Ser9ei/usbasp/circuit/USBisp_schematics.pdf

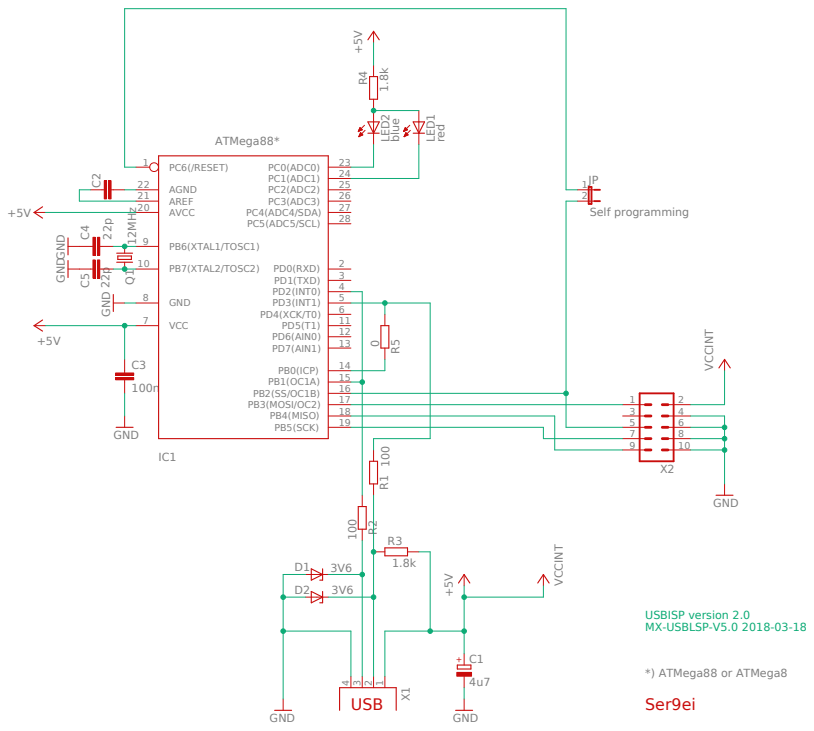
[picture p1: page 1]
