Ser9ei/usbasp/circuit/USBisp.sch

## EAGLE design circuit/USBisp.sch (2020-11-28)

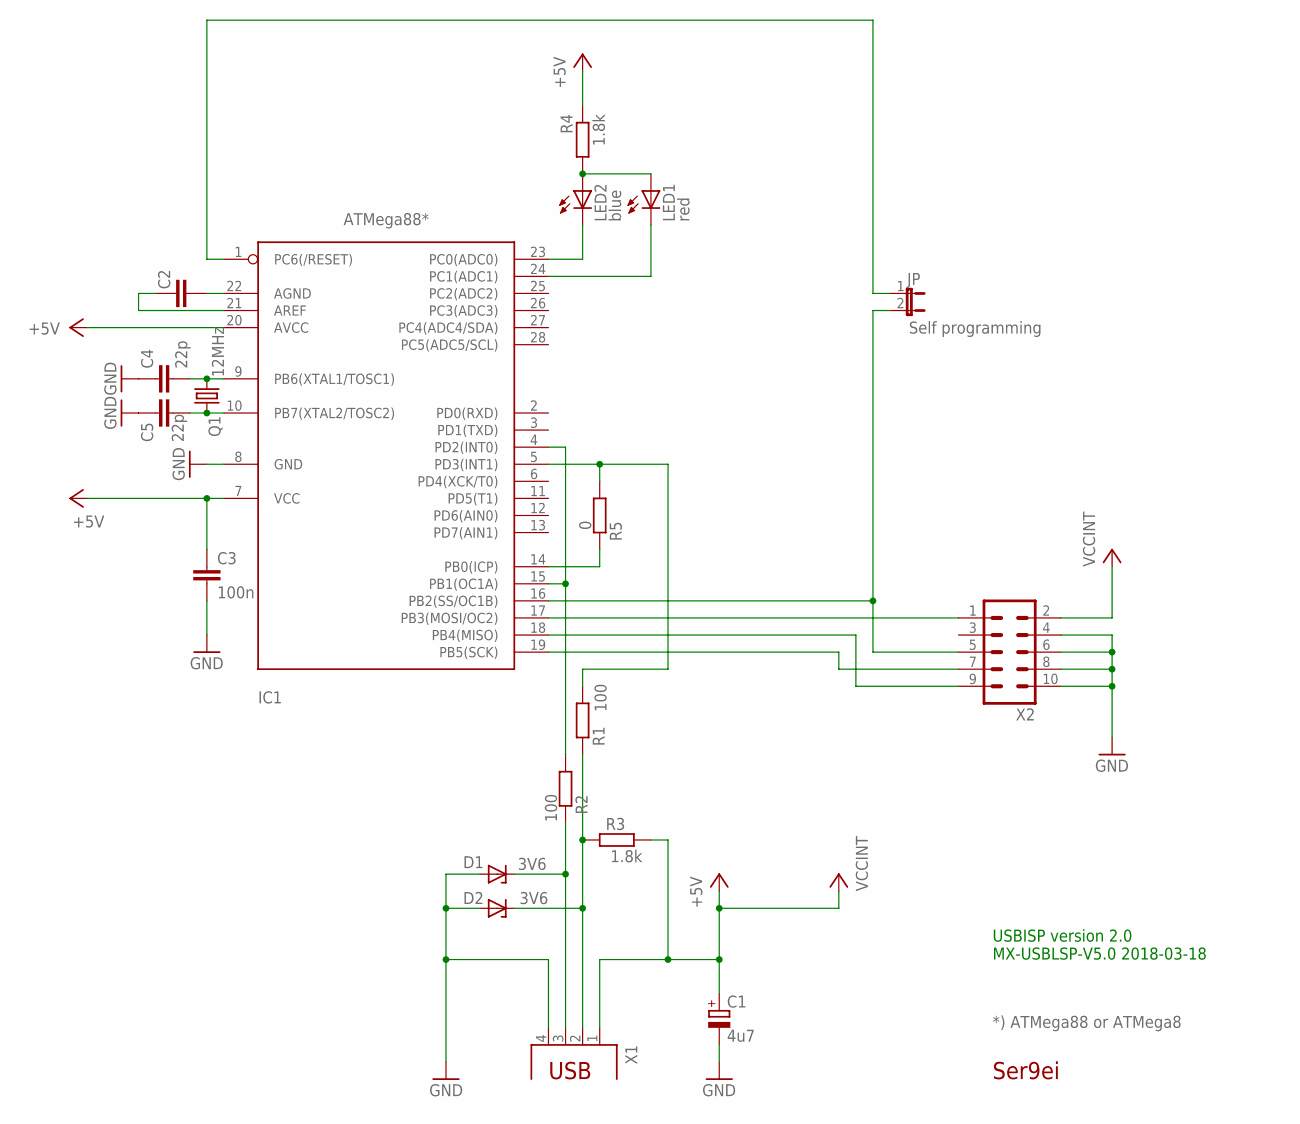
[picture p2: schematic USBisp.sch]

Parts:
C1: 4u7; E2,5-5
C2: C-EU025-024X044; C025-024X044
C3: 100n; C025-024X044
C4, C5: 22p; C025-024X044
D1, D2: 3V6; DO34Z7
IC1: ATMega88*; DIL28-3
JP: Self programming; JP1
LED1: red; LED3MM
LED2: blue; LED3MM
Q1: 12MHz; HC49/S
R1, R2: 100; 0207/10
R3, R4: 1.8k; 0207/10
R5: 0; 0207/10
X1: PN61729
X2: ML10L

Connections:
+5V: C1.+, C3.1, IC1.7 (VCC), IC1.20 (AVCC), R3.1, R4.1, X1.1
GND: C1.-, C3.2, C4.1, C5.1, D1.A, D2.A, IC1.8 (GND), X1.4, X2.4, X2.6, X2.8, X2.10
unnamed: IC1.1 (PC6(/RESET)), JP.1
unnamed: IC1.16 (PB2(SS/OC1B)), JP.2, X2.5
unnamed: IC1.17 (PB3(MOSI/OC2)), X2.1
unnamed: IC1.19 (PB5(SCK)), X2.7
unnamed: D2.C, R1.1, R3.2, X1.2
unnamed: IC1.18 (PB4(MISO)), X2.9
unnamed: IC1.4 (PD2(INT0)), IC1.15 (PB1(OC1A)), R2.2
unnamed: D1.C, R2.1, X1.3
unnamed: C2.1, IC1.22 (AGND)
unnamed: C2.2, IC1.21 (AREF)
unnamed: IC1.14 (PB0(ICP)), R5.1
unnamed: LED1.A, LED2.A, R4.2
unnamed: IC1.23 (PC0(ADC0)), LED2.K (C)
unnamed: IC1.24 (PC1(ADC1)), LED1.K (C)
unnamed: IC1.5 (PD3(INT1)), R1.2, R5.2
unnamed: C4.2, IC1.9 (PB6(XTAL1/TOSC1)), Q1.2
unnamed: C5.2, IC1.10 (PB7(XTAL2/TOSC2)), Q1.1
VCCINT: X2.2

Notes on the sheet:
Ser9ei
*) ATMega88 or ATMega8
USBISP version 2.0 MX-USBLSP-V5.0 2018-03-18
