Ser9ei/usbasp/(commit log)

2020-11-23 Initial version copied from https://www.fischl.de/usbasp usbasp.2011-05-28.tar.gz
    [USBasp.sch]
2020-11-24 update v-usb driver 20121206
    https://github.com/obdev/v-usb/releases/tag/releases%2F20121206
2020-11-24 fix main.c according to v-usb new notation
    [main.c]
2020-11-28 usbisp schema
    USBISP version 2.0MX-USBLSP-V5.0 2018-03-1
    [USBisp.sch]
2021-03-30 Added auto-speed
    Added auto-speed (downshift speed) support feature in case error with connection to the target
    [main.c]
2021-03-30 Update main.c
    fixed error in the last commit
    [main.c]
2021-03-30 Revert "Update main.c"
    This reverts commit f4415b1d698dbca032a2d31b4d859a71f1de29aa.
    [main.c]
